denjinelectric/Bio_Measurement/PCB/ECG/polygraph4.stl

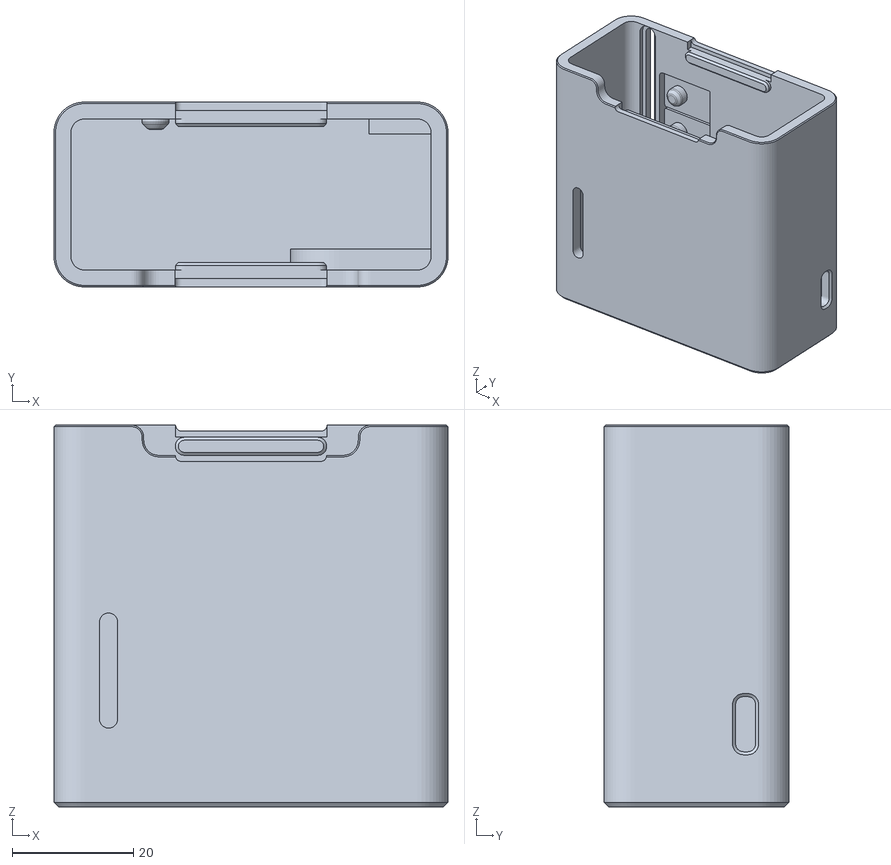
[picture p1: CAD file, 2026-01-29, last stored version]
PCB/ECG/polygraph4.stl
65.0 x 30.5 x 63.0
