denjinelectric/Bio_Measurement/PCB/ECG/polygraph1.step

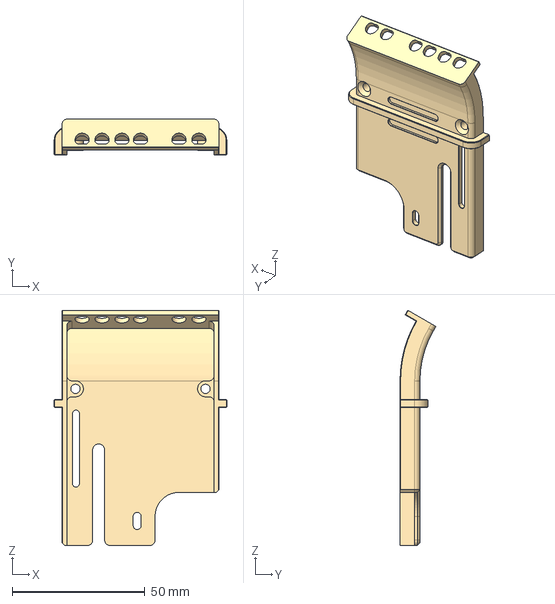
[picture p2: CAD file, 2026-01-29, last stored version]
PCB/ECG/polygraph1.step
65.0 x 13.5 x 88.5 mm
