denjinelectric/Bio_Measurement/PCB/ECG/polygraph3.stl

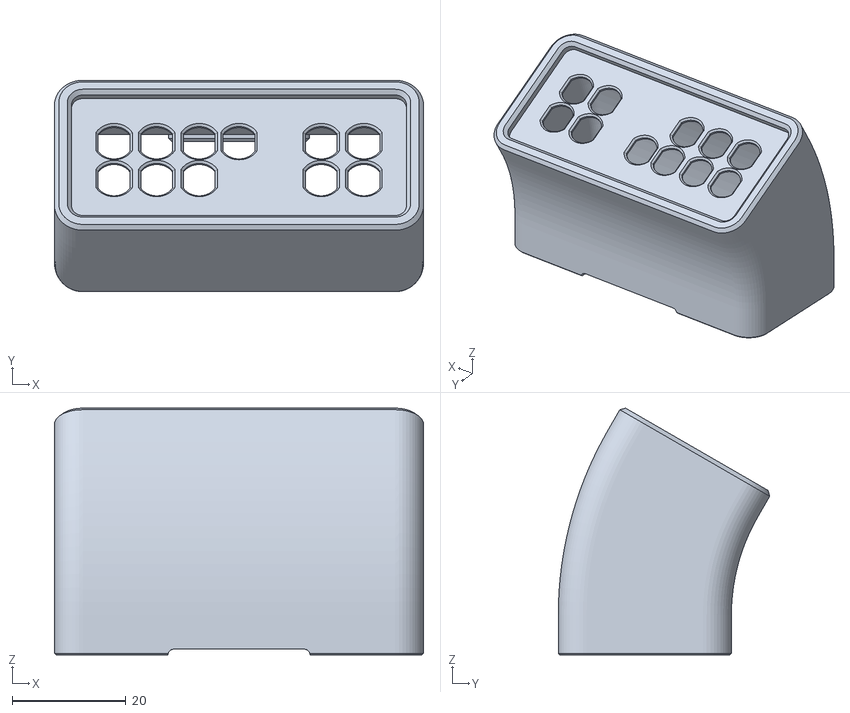
[picture p3: CAD file, 2026-01-29, last stored version]
PCB/ECG/polygraph3.stl
65.0 x 37.2 x 43.5
