denjinelectric/Bio_Measurement/PCB/ECG/polygraph2.step

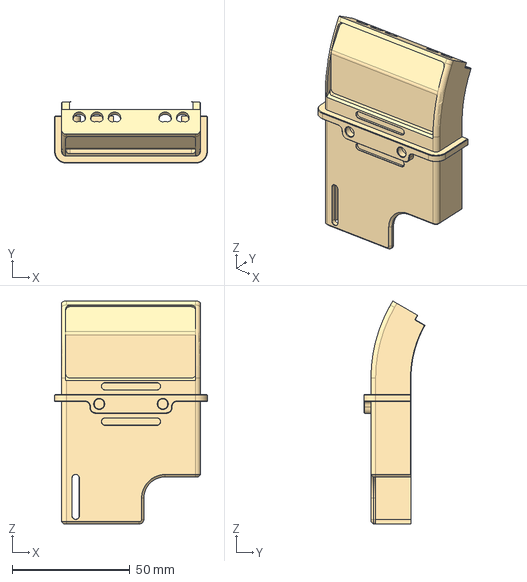
[picture p4: CAD file, 2026-01-29, last stored version]
PCB/ECG/polygraph2.step
65.0 x 26.0 x 94.7 mm
