denjinelectric/Bio_Measurement/PCB/ECG/ECG.kicad_pcb

## KiCad design PCB/ECG/ECG.kicad_pcb (2026-01-29, last stored version)

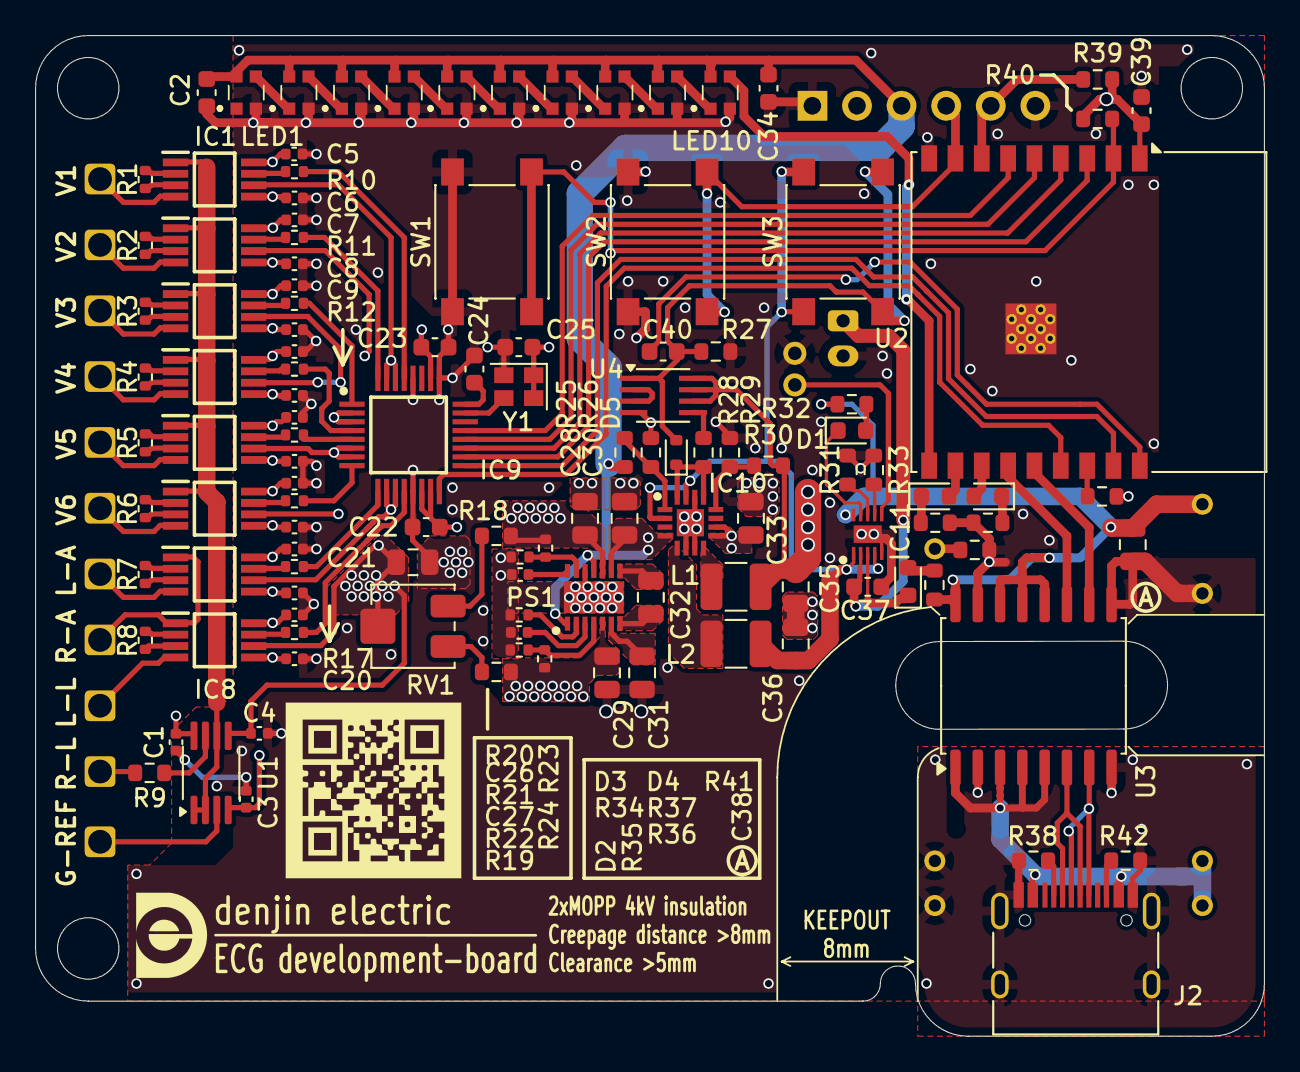
[picture p5: board ECG.kicad_pcb from above]

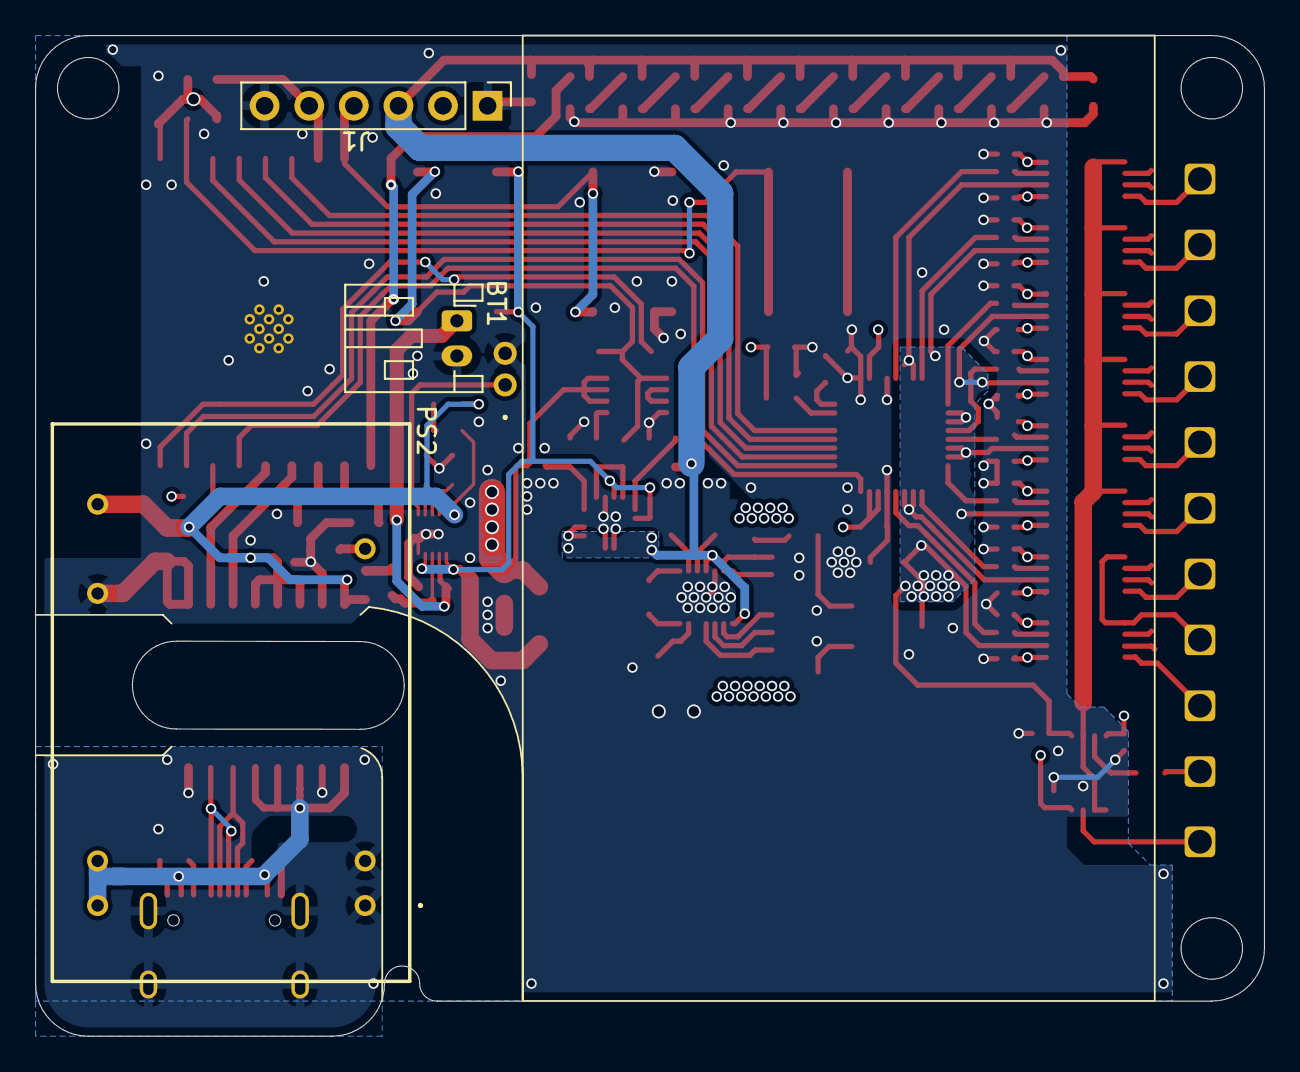
[picture p6: board ECG.kicad_pcb from below]

Board: 4 copper layers, 70.0 x 57.0 mm, 137 parts (4 on the bottom side), 115 nets.

Parts:
 : LOGO; logo2
BT1: Battery_Cell; JST_PH_S2B-PH-K_1x02_P2.00mm_Horizontal
C1, C3, C4, C5, C6, C7, C8, C9, C10, C11, C12, C13, C14, C15, C16, C17, C18, C19, C20, C26, C27: 0.01uF; C_0402_1005Metric
C2, C25, C34, C37, C39: 0.1u; C_0603_1608Metric
C21, C30, C32, C33, C35, C36, C38: 1u; C_0805_2012Metric
C22, C23: 1u; C_0603_1608Metric
C24: 0.22u; C_0603_1608Metric
C28, C29, C31: 10uF; C_0805_2012Metric
C40: 0.01uF; C_0603_1608Metric
D1, D2, D3, D4: LED; LED_0603_1608Metric
D5: RB520S; D_SOD-523
IC1, IC2, IC3, IC4, IC5, IC6, IC7, IC8: AD8220BRMZ-RL; SOP65P490X110-8N
IC9: ADS131M08IPBS; QFP50P700X700X120-32N
IC10: LTC3523EUD-2#TRPBF; QFN50P300X300X80-17N-D
IC11: BQ25185DLHR; SON40P220X200X80-11N
J1: Conn_01x06_Socket; PinHeader_1x06_P2.54mm_Vertical
J2: USB_C_Receptacle_USB2.0_16P; USB_C_Receptacle_HRO_TYPE-C-31-M-12
L1, L2: 4.7uH; L_1210_3225Metric
LED1, LED2, LED3, LED4, LED5, LED6, LED7, LED8, LED9, LED10: WS2812C-2020; WS2812C2020
PS1: LTC3260IDE#PBF; SON50P300X400X80-15N-D
PS2: JHM1005S05
R1, R2, R3, R4, R5, R6, R7, R8: 499±0.1%; R_0402_1005Metric
R9, R32, R36: 1k; R_0603_1608Metric
R10, R11, R12, R13, R14, R15, R16, R17: 10k±0.1%; R_0402_1005Metric
R18, R19, R28, R34, R37, R39, R40, R41: 10k; R_0603_1608Metric
R20, R22: 12k±0.25%; R_0402_1005Metric
R21: 100k; R_0402_1005Metric
R23: 21k±0.25%; R_0402_1005Metric
R24: 1k±0.25%; R_0402_1005Metric
R25: 15K±0.5%; R_0603_1608Metric
R26: 4.7k±0.5%; R_0603_1608Metric
R27: 40k; R_0603_1608Metric
R29: 4K±0.5%; R_0603_1608Metric
R30: 18k±0.5%; R_0603_1608Metric
R31, R33, R35, R38, R42: 5k±0.1%; R_0603_1608Metric
RV1: 10k; Potentiometer_Bourns_3314J_Vertical
SW1, SW2, SW3: SW_Push; SW_SPST_PTS645
TH1: 10k NTC; 103JT050
TP1, TP2, TP3, TP4, TP5, TP6, TP7, TP8, TP9, TP10, TP11: Pin socket; RI-1S0-SG4.2SMT
U1: AD8606ARM; MSOP-8_3x3mm_P0.65mm
U2: ESP32-C3-WROOM-02
U3: ADUM4160; SOIC-16W_7.5x10.3mm_P1.27mm
U4: TC74WH74FU; SSOP-8_2.95x2.8mm_P0.65mm
Y1: SG-210STF; Oscillator_SMD_SeikoEpson_SG210-4Pin_2.5x2.0mm

Connections:
+5V: C2.1, C30.1, C33.1, C34.1, IC10.4 (VOUT), IC10.9 (VIN2), IC10.10 (MODE), J1.3, LED1.4 (VDD), LED2.4 (VDD), LED3.4 (VDD), LED4.4 (VDD), LED5.4 (VDD), LED6.4 (VDD), LED7.4 (VDD), LED8.4 (VDD), LED9.4 (VDD), LED10.4 (VDD), PS1.1 (EN+), PS1.9 (VIN), PS1.11 (EN-), R25.2
+BATT: C36.1, IC10.2 (VIN1), IC10.15 (VBAT), IC11.1 (SYS), IC11.4 (~CE), L2.1, SW3.2
-5V: C31.2, PS1.6 (VOUT)
CLK: IC9.23 (XTAL1/CLKIN), Y1.3 (OUT)
CS0: IC9.17 (~CS), U2.17 (IO1)
DIN: IC9.21 (DIN), U2.6 (IO7)
DOUT: IC9.20 (DOUT), U2.5 (IO6)
DRDY: IC9.18 (~DRDY), U2.3 (IO4)
GND: C4.1, C21.1, IC1.6 (REF), IC2.6 (REF), IC3.6 (REF), IC4.6 (REF), IC5.6 (REF), IC6.6 (REF), IC7.6 (REF), IC8.6 (REF), IC9.2 (AIN2N), IC9.3 (AIN3N), IC9.6 (AIN4N), IC9.7 (AIN5N), IC9.10 (AIN6N), IC9.11 (AIN7N), IC9.30 (AIN0N), IC9.31 (AIN1N), RV1.2, U1.5 (+)
GND2: J2.A1 (GND), J2.A12 (GND), J2.B1 (GND), J2.B12 (GND), J2.S1 (SHIELD), PS2.2 (-VIN_1), PS2.3 (-VIN_2), R38.1, R42.1, U3.2 (GND1), U3.8 (GND1)
GNDPWR: BT1.2 (-), C1.2, C2.2, C3.2, C4.2, C5.2, C6.2, C7.2, C8.2, C9.2, C10.2, C11.2, C12.2, C13.2, C14.2, C15.2, C16.2, C17.2, C18.2, C19.2, C20.2, C21.2, C22.1, C23.1, C24.1, C25.2, C26.2, C27.2, C28.1, C29.1, C30.2, C31.1, C33.2, C34.2, C35.2, C36.2, C37.2, C38.2, C39.2, IC9.13 (AGND_1), IC9.25 (DGND), IC9.28 (AGND_2), IC10.6 (GND1), IC10.7 (GND2), IC10.14 (GND3), IC10.17 (GND), IC11.5 (GND), IC11.11 (EP), J1.1, J1.6, LED1.2 (GND), LED2.2 (GND), LED3.2 (GND), LED4.2 (GND), LED5.2 (GND), LED6.2 (GND), LED7.2 (GND), LED8.2 (GND), LED9.2 (GND), LED10.2 (GND), PS1.12 (MODE), PS1.15 (GND), PS2.16 (-VOUT), R20.2, R21.2, R22.2, R26.1, R27.1, R29.2, R31.1, R33.1, R34.2, R36.1, R37.2, SW1.1, SW2.1, TH1.2, U2.9 (GND), U2.19 (GND), U3.9 (GND2), U3.15 (GND2), U4.4 (GND), Y1.2 (GND)
GNDREF: IC1.1 (-IN), IC2.1 (-IN), IC3.1 (-IN), IC4.1 (-IN), IC5.1 (-IN), IC6.1 (-IN), U1.1, U1.2 (-), U1.6 (-)
GNDREF-in: TP11.1, U1.3 (+)
I: IC9.9 (AIN6P), R16.1
II: IC9.12 (AIN7P), R17.1
L-ARM: IC7.4 (+IN), TP7.1
L-LEG: IC8.4 (+IN), TP9.1
unnamed: BT1.1 (+), C37.1, IC11.2 (BAT)
unnamed: D1.2 (A), R32.1
unnamed: D1.1 (K), IC11.9 (STAT1)
unnamed: D2.2 (A), R35.1
unnamed: D2.1 (K), IC11.3 (STAT2)
unnamed: D3.2 (A), U2.11 (IO20/RXD)
unnamed: D3.1 (K), R34.1
unnamed: D4.2 (A), U2.12 (IO21/TXD)
unnamed: D4.1 (K), R37.1
unnamed: C40.1, D5.2 (A), R27.2, SW3.1, U4.1 (C)
unnamed: D5.1 (K), IC10.13 (~SHDN2), IC10.16 (~SHDN1), R28.2
unnamed: IC1.4 (+IN), TP1.1
unnamed: IC1.2 (RG_1), R1.2
unnamed: IC1.3 (RG_2), R1.1
unnamed: IC1.7 (VOUT), R10.2
unnamed: IC2.4 (+IN), TP2.1
unnamed: IC2.2 (RG_1), R2.2
unnamed: IC2.3 (RG_2), R2.1
unnamed: IC2.7 (VOUT), R11.2
unnamed: IC3.4 (+IN), TP3.1
unnamed: IC3.2 (RG_1), R3.2
unnamed: IC3.3 (RG_2), R3.1
unnamed: IC3.7 (VOUT), R12.2
unnamed: IC4.4 (+IN), TP4.1
unnamed: IC4.2 (RG_1), R4.2
unnamed: IC4.3 (RG_2), R4.1
unnamed: IC4.7 (VOUT), R13.2
unnamed: IC5.4 (+IN), TP5.1
unnamed: IC5.2 (RG_1), R5.2
unnamed: IC5.3 (RG_2), R5.1
unnamed: IC5.7 (VOUT), R14.2
unnamed: IC6.4 (+IN), TP6.1
unnamed: IC6.2 (RG_1), R6.2
unnamed: IC6.3 (RG_2), R6.1
unnamed: IC6.7 (VOUT), R15.2
unnamed: IC7.2 (RG_1), R7.2
unnamed: IC7.3 (RG_2), R7.1
unnamed: IC7.7 (VOUT), R16.2
unnamed: IC8.2 (RG_1), R8.2
unnamed: IC8.3 (RG_2), R8.1
unnamed: IC8.7 (VOUT), R17.2
unnamed: C24.2, IC9.24 (CAP)
unnamed: IC10.1 (FB1), R25.1, R26.2
unnamed: IC10.12 (FB2), R29.1, R30.2
unnamed: IC10.5 (SW1), L2.2
unnamed: IC10.8 (SW2), L1.1
unnamed: IC11.7 (ILIM/VSET), R33.2
unnamed: C38.1, IC11.10 (IN), PS2.14 (+VOUT), R32.2, R35.2, U3.12 (PIN), U3.13 (SPD), U3.14 (VDD2), U3.16 (VBUS2)
unnamed: IC11.8 (ISET), R31.2
unnamed: IC11.6 (TS/MR), TH1.1
unnamed: J2.A5 (CC1), R38.2
unnamed: J2.B5 (CC2), R42.2
unnamed: LED1.3 (DI), LED2.1 (DO)
unnamed: LED2.3 (DI), LED3.1 (DO)
unnamed: LED3.3 (DI), LED4.1 (DO)
unnamed: LED4.3 (DI), LED5.1 (DO)
unnamed: LED5.3 (DI), LED6.1 (DO)
unnamed: LED6.3 (DI), LED7.1 (DO)
unnamed: LED7.3 (DI), LED8.1 (DO)
unnamed: LED8.3 (DI), LED9.1 (DO)
unnamed: LED10.3 (DI), U2.10 (IO10)
unnamed: LED9.3 (DI), LED10.1 (DO)
unnamed: PS1.13 (ADJ+), R20.1, R23.1
unnamed: PS1.4 (ADJ-), R22.1, R24.1
unnamed: C26.1, PS1.14 (BYP+)
unnamed: C27.1, PS1.3 (BYP-)
unnamed: C32.1, PS1.8 (C+)
unnamed: C32.2, PS1.7 (C-)
unnamed: PS1.2 (RT), R21.1
unnamed: J2.A4 (VBUS), J2.A9 (VBUS), J2.B4 (VBUS), J2.B9 (VBUS), PS2.22 (+VIN_1), PS2.23 (+VIN_2), U3.1 (VBUS1), U3.3 (VDD1), U3.4 (PDEN), U3.5 (SPU)
unnamed: PS2.10 (TRIM), R36.2
unnamed: R9.1, U1.7
unnamed: R18.1, RV1.1
unnamed: R19.2, RV1.3
unnamed: R40.1, SW1.2, U2.2 (EN)
unnamed: R41.1, U2.16 (IO2)
unnamed: J2.A6 (D+), J2.B6 (D+), U3.7 (UD+)
unnamed: J2.A7 (D-), J2.B7 (D-), U3.6 (UD-)
unnamed: U4.2 (D), U4.3 (~Q)
unnamed: R28.1, U4.5 (Q)
PWR-OFF: C40.2, U2.18 (IO0)
R-ARM: IC7.1 (-IN), IC8.1 (-IN), TP8.1
R-LEG: R9.2, TP10.1
SCL: J1.4, SW2.2, U2.8 (IO9)
SCLK: IC9.19 (SCLK), U2.4 (IO5)
SDA: J1.5, R39.1, U2.7 (IO8)
SYNC/RESET: IC9.16 (~SYNC/~RESET), U2.15 (IO3)
USB_D+: U2.14 (IO19), U3.10 (DD+)
USB_D-: U2.13 (IO18), U3.11 (DD-)
V1: IC9.29 (AIN0P), R10.1
V2: IC9.32 (AIN1P), R11.1
V3: IC9.1 (AIN2P), R12.1
V4: IC9.4 (AIN3P), R13.1
V5: IC9.5 (AIN4P), R14.1
V6: IC9.8 (AIN5P), R15.1
VCC: C1.1, C5.1, C7.1, C9.1, C11.1, C13.1, C15.1, C17.1, C19.1, C22.2, C28.2, IC1.8 (+VS), IC2.8 (+VS), IC3.8 (+VS), IC4.8 (+VS), IC5.8 (+VS), IC6.8 (+VS), IC7.8 (+VS), IC8.8 (+VS), IC9.14 (REFIN), IC9.15 (AVDD), PS1.10 (LDO+), R18.2, R23.2, U1.8 (V+)
VDD: C23.2, C25.1, C35.1, C39.1, IC9.26 (DVDD), J1.2, L1.2, R30.1, R39.2, R40.2, R41.2, U2.1 (3V3), U4.6 (~CLR), U4.7 (~PRE), U4.8 (VCC), Y1.1 (~ST), Y1.4 (Vcc)
VSS: C3.1, C6.1, C8.1, C10.1, C12.1, C14.1, C16.1, C18.1, C20.1, C29.2, IC1.5 (-VS), IC2.5 (-VS), IC3.5 (-VS), IC4.5 (-VS), IC5.5 (-VS), IC6.5 (-VS), IC7.5 (-VS), IC8.5 (-VS), PS1.5 (LDO-), R19.1, R24.2, U1.4 (V-)
